Fantom409/smart-display-esp32s3/hardware/stl/Body.stl

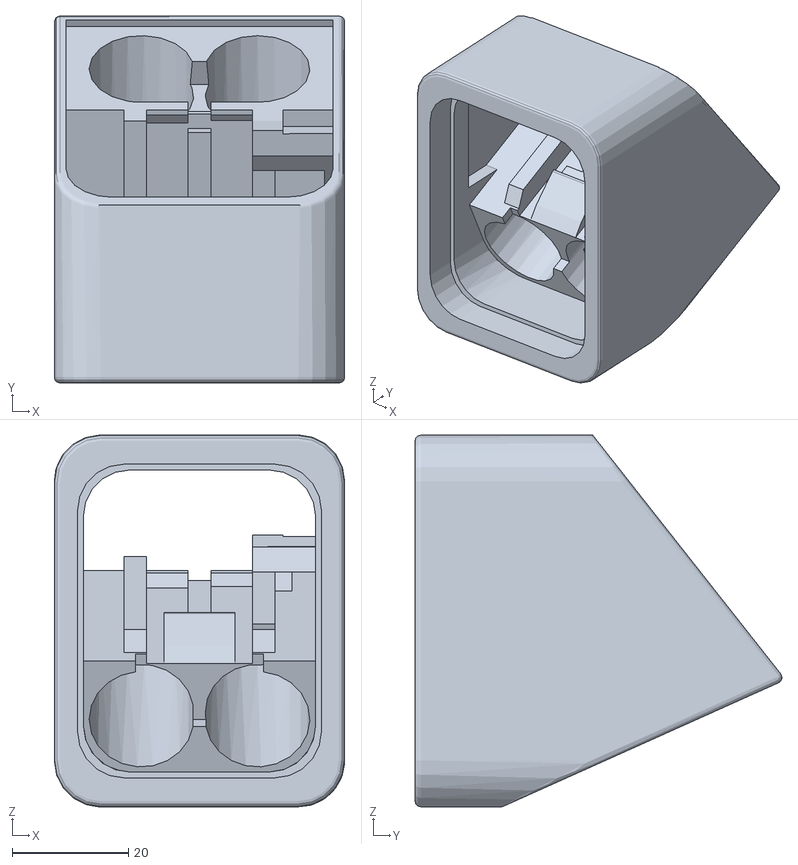
[picture p1: CAD file, 2026-11-01]
hardware/stl/Body.stl
50.0 x 63.2 x 64.0
