Fantom409/smart-display-esp32s3/hardware/stl/back_cover.stl

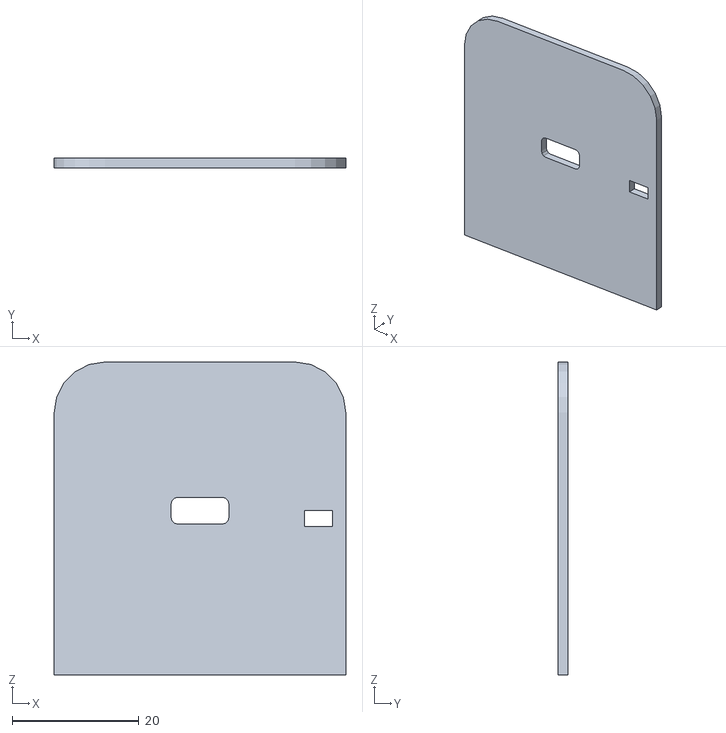
[picture p2: CAD file, 2026-11-01]
hardware/stl/back_cover.stl
46.0 x 1.50 x 49.3
