Fantom409/smart-display-esp32s3/hardware/stl/front+cover.stl

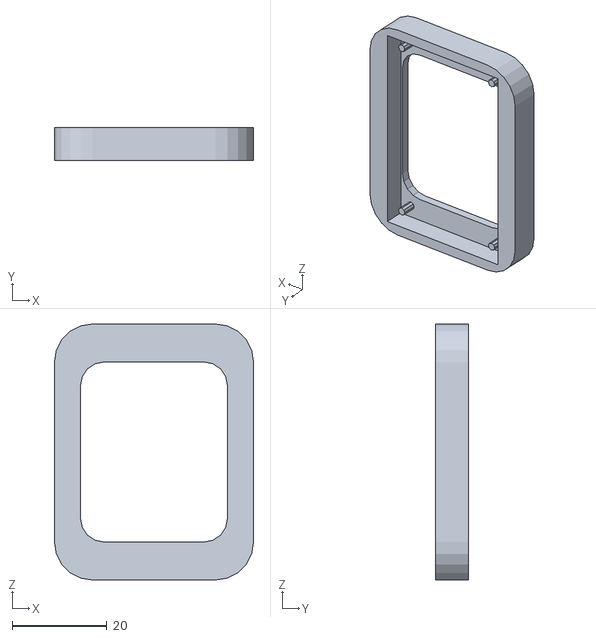
[picture p3: CAD file, 2026-11-01]
hardware/stl/front+cover.stl
42.0 x 7.00 x 54.0
